Serhiy-K/TFTGLCDAdapter/Hardware/Photos/README.md

# TFTGLCDPanel

**Start screen**

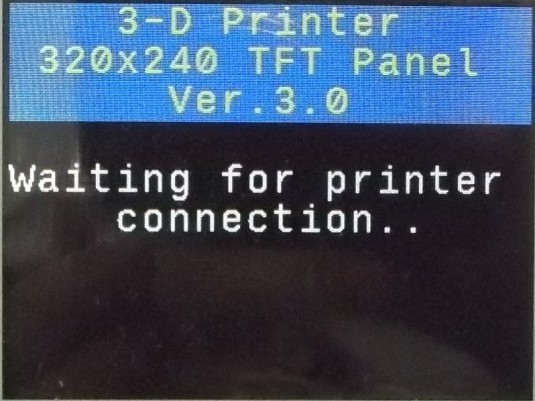
[picture p3: Hardware/Photos/Start-Logo.jpg]


**Marlin-2 logo**

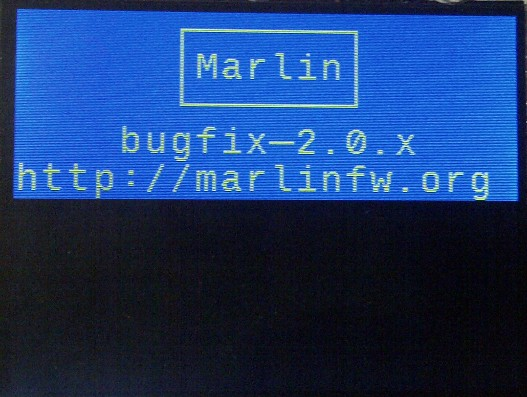
[picture p4: Hardware/Photos/Marlin-2-Logo.jpg]


**Status screen with 1 hotend and bed, Marlin**

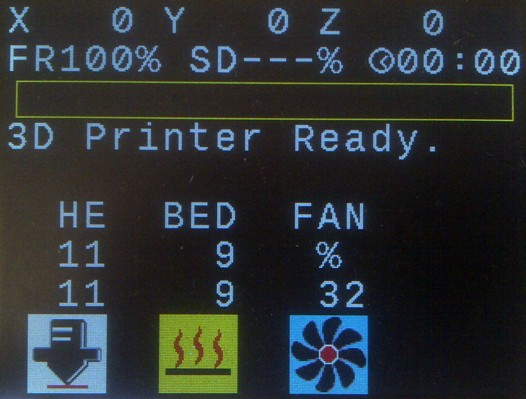
[picture p5: Hardware/Photos/Marlin-1HE.jpg]


**Status screen with 2 hotends, Marlin**

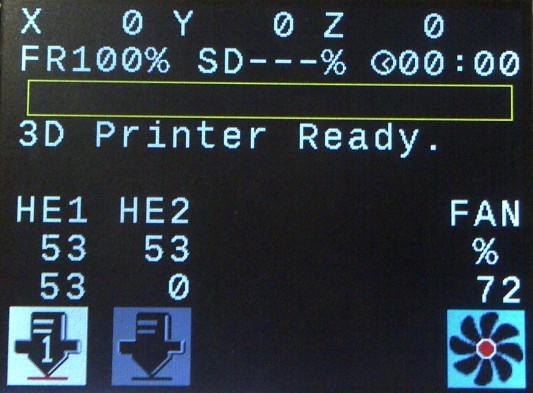
[picture p6: Hardware/Photos/Marlin-2HE.jpg]


**Status screen for lazer, Marlin**

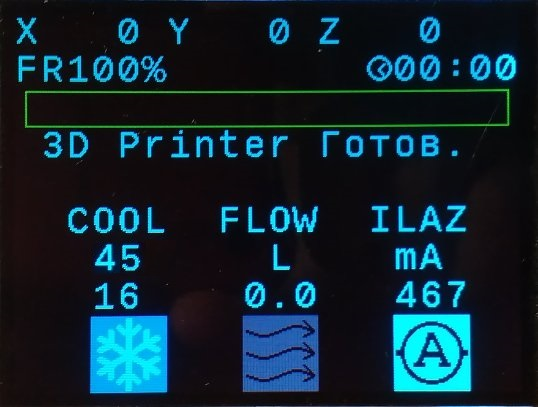
[picture p7: Hardware/Photos/Marlin-Lazer.jpg]


**Status screen with progressbar, Smoothieware**



**Menu, Smoothieware**

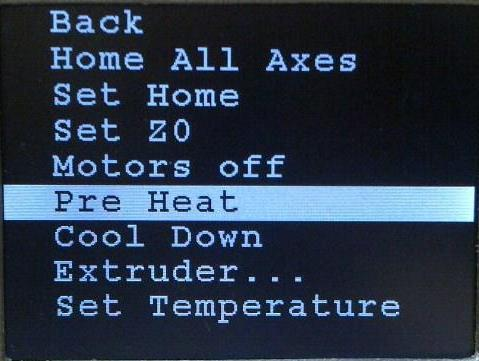
[picture p8: Hardware/Photos/Smoothie-menu.jpg]


**Edit parameter with encoder, Smoothieware**

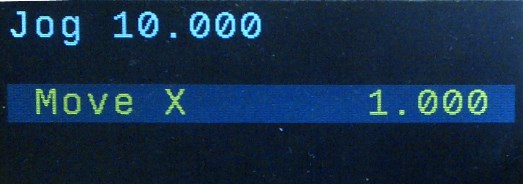
[picture p9: Hardware/Photos/Smoothie-Edit_Param.jpg]


**Edit parameter with touchscreen, Marlin**

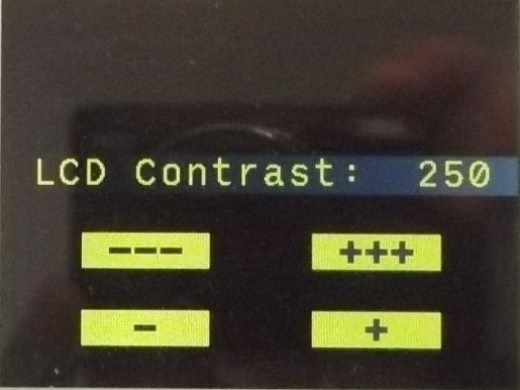
[picture p10: Hardware/Photos/Marlin-Edit_param-V3.jpg]


**UBL: edit mesh with encoder**

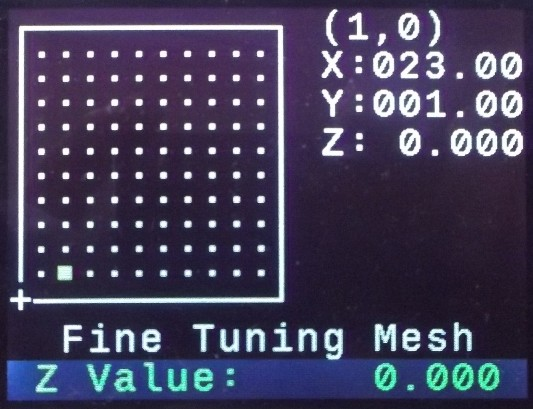
[picture p11: Hardware/Photos/UBL_Mesh_Editor_encoder.jpg]


**UBL: select point with touchscreen**

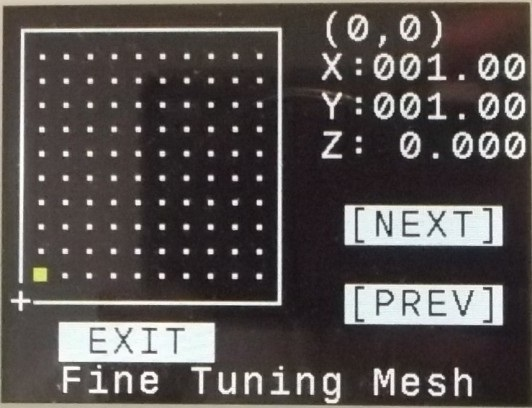
[picture p12: Hardware/Photos/UBL-select-V3.jpg]


**UBL: edit point with touchscreen**

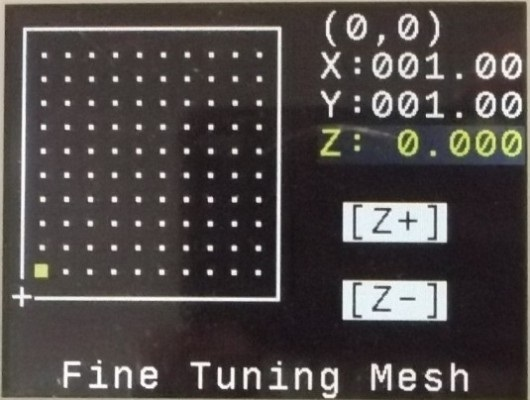
[picture p13: Hardware/Photos/UBL-edt-V3.jpg]


**Error screen, Marlin**

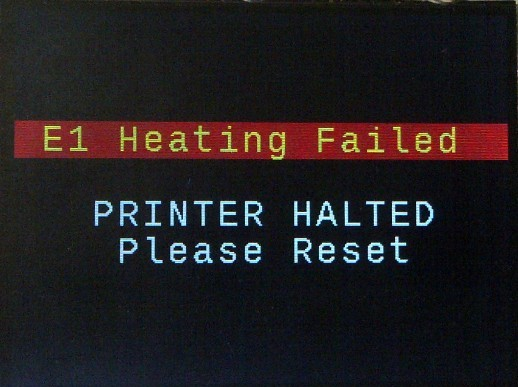
[picture p14: Hardware/Photos/Marlin-Error_Screen.jpg]


**TFTGLCD panel V2 PCB**

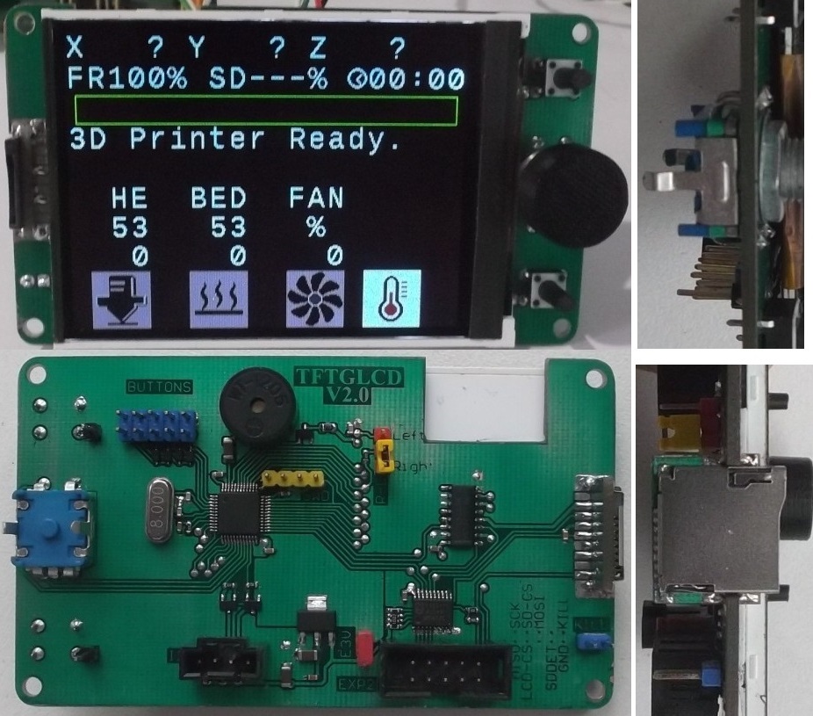
[picture p15: Hardware/Photos/TFTGLCD-V2.jpg]


**TFTGLCD panel V3 in case from chinese "mini Iphone"**

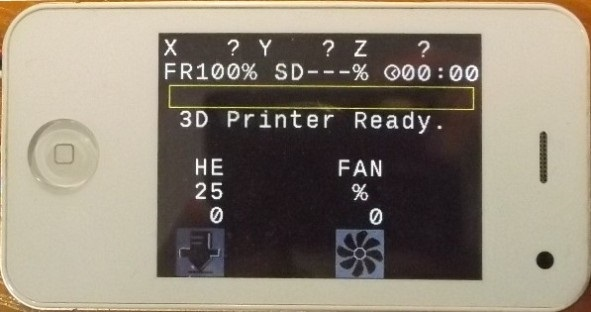
[picture p16: Hardware/Photos/TFTGLCD-V3.jpg]
