Serhiy-K/TFTGLCDAdapter/Firmware/Changelog.txt

01/28/2022

1. Add SD-Botloader support. Need new or changed hardware. See the differences between Version 2.0 and Version 2.1
   hardware for SD-card/SPI bus.
2. Now code support only Version 2.1 hardware for "HW_VER_2". Hardware Version 2.0 will work with this code too.
3. Update README files.

09/13/2021

1. Add "ONLY_MARLIN", "USE_SPI", "USE_I2C" options to reduce ROM size.

07/18/2021

1. Add cutter status for laser/spindle.

07/03/2021

1. Add support for laser in Marlin-2.

05/06/2021

1. Add support for HX8347 LCD chip.

04/01/2021

1. Add rotation for R61509V displays.
2. Remove unneeded code in LCD.c.

03/14/20221

1. Fix touchscreen for Smoothieware.
2. Fix FAN text output in main screen for Smoothieware.

03/06/2021

1. Cnange algorithm for Clear_Screen.

03/01/2021

1. Fix for return from edit contrast in Marlin.

28/02/2021

1. Add support for R61509V LCD chip.
2. Change I2C addres to 0x33 for STM32 main boards.
3. Fix I2C bus interrupt for touchscreen.
4. Fix "Bed" icon.

1. Optimize UBL output.
2. Add comment to touchscreen calibration screen.

12/10/2020

1. Add save/load Y-calibration.
2. Change one sybbol in font for touchscreen test.
3. Move touchscreen functions to separate file.

12/09/2020

1. Add touchscreen rotation according to LCD.

12/06/2020

1. Touchscreen support works fine.
2. Change some pins for LCD for HW_VER_3.

11/08/2020

1. Change output algorithm - remove screen autorefresh.
2. Ad new hardware version for touchscreen for future. Not tested in hardware yet.
3. Add separate timer for buttons and touchscreen.

10/09/2020

1. Change for buttons.

10/04/2020

1. Small code clean up.
2. Change output for icons for extrude1..extrude3 for multiextruder config to icon for single extrude to free ROM.
   Icons for extrude1..extrude3 not deleted from sources and may be used.
3. Small change for progress bar output.

10/03/2020

1. Fix Buzzer for Marlin.
2. Update for Marlin's edit line.
3. Formating defines.h

09/30/2020

1. Add CLR_SCREEN command for Marlin to protocol - optimize bus transfer.
2. Update Readme.

09/25/2020

1. Fix progress bar for Marlin.
2. Change progress bar colors.

09/10/2020

1. Small fix for UBL screen for Marlin.

09/06/2020

1. Fix buttons for Marlin.

09/05/2020

1. Improvement for detect UBL screen.

08/31/2020

1. Remove "symbol" for FAN percent data in line 4 for Smoothieware.
2. Small changes in Courier font.

08/29/2020

1. Add centring for status line on main screen.

08/23/2020

1. Small changes in LiberationMono font.

08/17/2020

1. Fix protocol for Marlin.
2. Fix UBL screen for Marlin.

29/06/2020

1. Add ST7789 LCD chip support.
2. Add dots to grid for Marlin UBL.

06/25/2020

1. Fix init for ILI9341 and ILI9327.

06/20/2020

1. Add new hardware version for support real 16 bit LCD data bus.
2. Remove support 16-bit LCD data bus with 8-bit controller data bus.
3. Change algorithm for output screen buffer.
4. Change encoder init to use gpio interrupt insted STM32 hardware encoder interface.
5. Add LCD_ORIENT_PIN - hardware selection for LCD orientation.
6. Fix 3 chars in LiberationMono font.
7. Fix logo output for Marlin.

03/20/2020

1. Add support for LCD with 16-bit data bus.

02/19/2020

1. Optimize output to screen.
2. Change BUZ_MIN_FREQ to BUZ_FREQ_MP for change input buzzer frequency.

02/12/2020

1. Change project structure - add inc directory, move all project *.h files to it, move main.c to src.
2. Fix wrong start "shadow" icons.
3. Add new BUZ_MIN_FREQ parameter for set minimum frequency for buzzer.
4. Add Makefile and STM32F103C8Tx_FLASH.ld for buld without CoIDE.
5. Add VSCode support.

02/10/2020

1. Change encoder init for INVERT_ENCODER_DIR param.

01/20/2020

1. Change Start Screen text.
2. Small code formating.

01/07/2020

1. Remove transcode from HD44780 encoding. Marlin should send text in extended ASCII with corresponded national codepage.
   Panel font must have the same codepage to outout all national symbols and pseudographic symbols.
2. Add support for buzzer frequency change for Marlin.

11/10/2019

1. Fix error with temps number set for Marlin.
2. Return back two new commands for Marlin.
3. Change in contrast setting.
4. Add grey-color icons for OFF states for hotends, bed and fan.
5. Change some color positions in colors definition for icons.

10/28/2019

1. Code optimisation.
2. Add centering text for Smoothieware on 400x240 LCD.
3. Fix small bugs for output on 400x240 LCD.
4. Change positions for first lines and progressbar for Smoothieware.
5. Update and add new fotos.

10/20/2019

1. Change init and text resolution for ILI9327 LCD. Now screen equal to 24x10 text screen
2. Change for icons output.
3. Remove unneeded commands for Marlin.
4. Add colors selection for menu cursor for Marlin and Smoothieware and error message and edit parameter line for Marlin.
5. Add drawing frame for UBL in Marlin.
6. Add minimum duration for buzzer.
7. Add CHAR_WIDTH-depended posisions for icons.
8. Update and add new fotos.

09/29/2019

1. Add INVERT_ENCODER_DIR option for encodres with swaped A and B signals.
2. Add WITHOUT_HEAT_ICO option for printing "FAN %" text insteed heat icon.
3. Fix printing temterature/fan lines and heat icon position.

09/09/2019

1. Fix error with icons clearing for Marlin.
2. Small change in progress bar drawing.
3. Moving some lines up in defines.h.

09/06/2019

1. Add support for LCD based on ILI9341 chip
2. Set more light blue color for FAN icons

09/04/2019

1. Correction for LCD based on ILI9327 chip.

08/30/2019

1. Change data format for icons

08/27/2019

1. Add I2C bus to schematic and PCB for support Marlin.
2. Add Gerber files for PCB.

08/22/2019

1. Add support for Marlin 1.1.x (by using I2C bus).
2. Change default font to LiberationMono-Regular_16x24, Courier_New_Bold_16x24 left for choice. Some symbols was changed for better reading.
3. Change first 11 default ASCII symbols in font for using with Marlin.
4. Add Progress bar for Smoothieware.
5. Add auto detect adapter resolution for Smoothieware.
6. Add auto detect numbers of hotends for proper icons positions.
7. Add basic support for LCD based on ILI9327 chip with 400x240 screen resolution.
