Serhiy-K/TFTGLCDAdapter/Hardware/AltiumProj/Ver-3/TFTGLCD-V3-sch.pdf

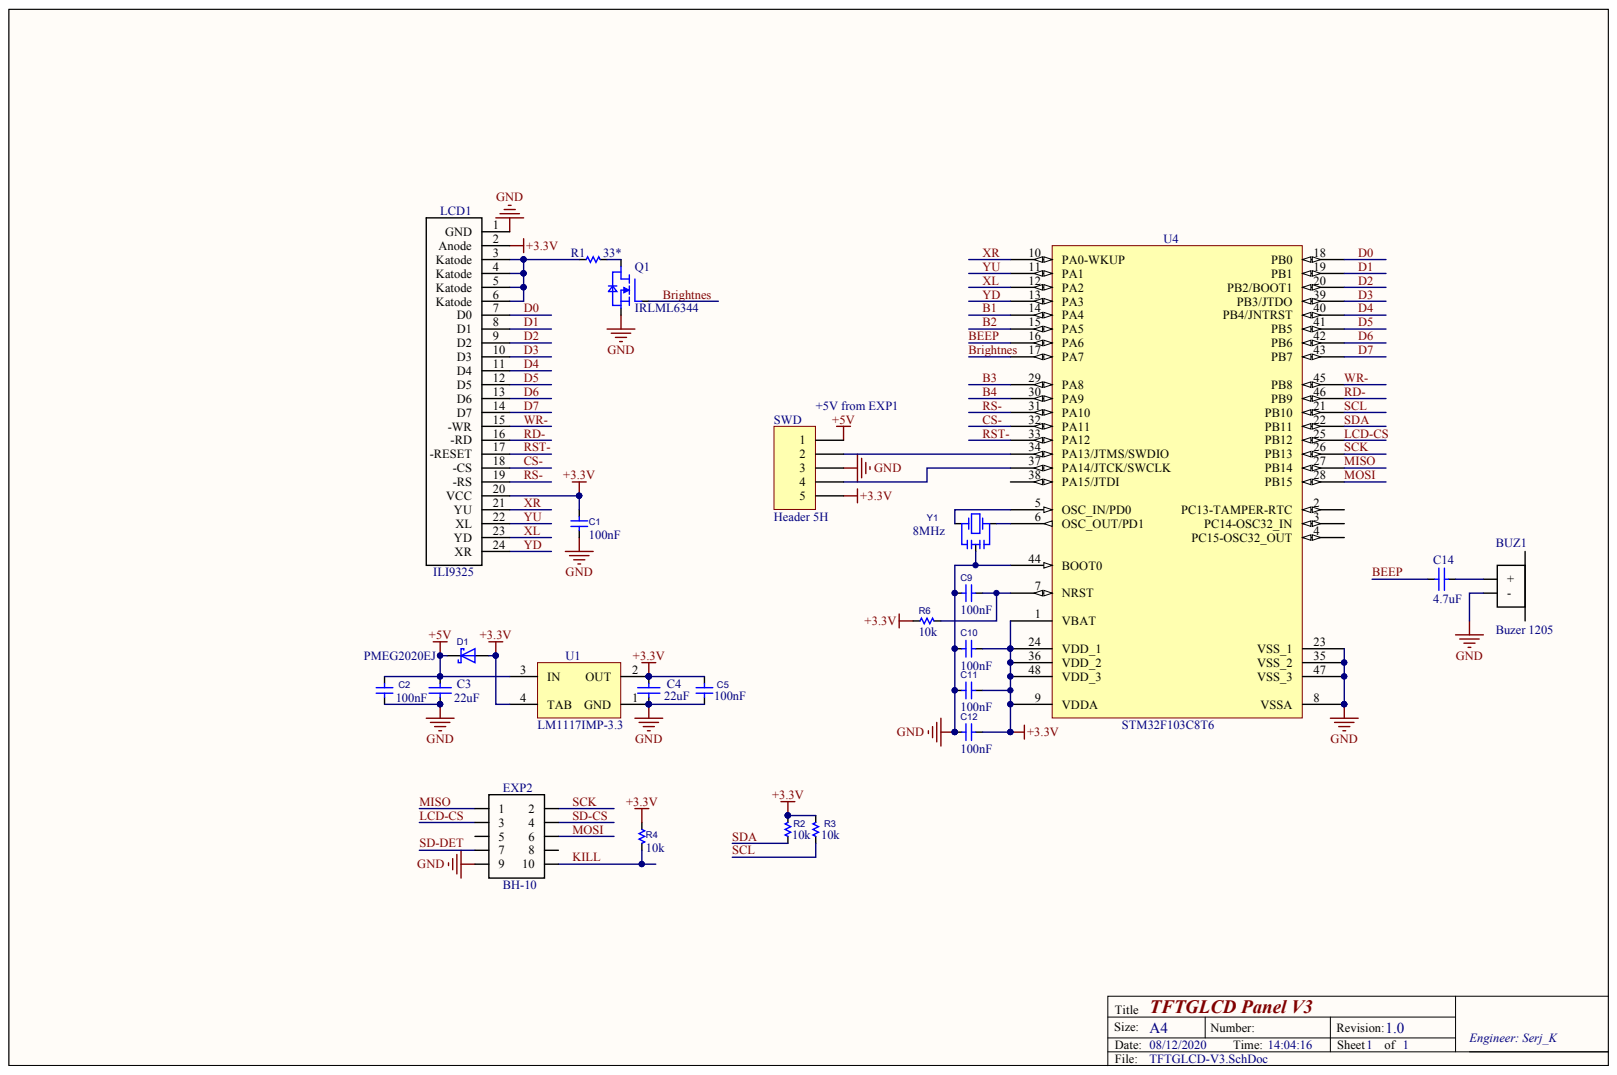
[picture p17: page 1]

PA15/JTDI 38

TFTGLCD Panel V3 Ti t l e | Engineer: Serj_K
Size: A4 | Number: | Revision: 1.0
Date: 08/12/2020 Ti me: 14:04:16 | | Sheet 1 of 1
