Serhiy-K/TFTGLCDAdapter/Hardware/AltiumProj/Ver-2/TFTGLCD-V2.1.pdf

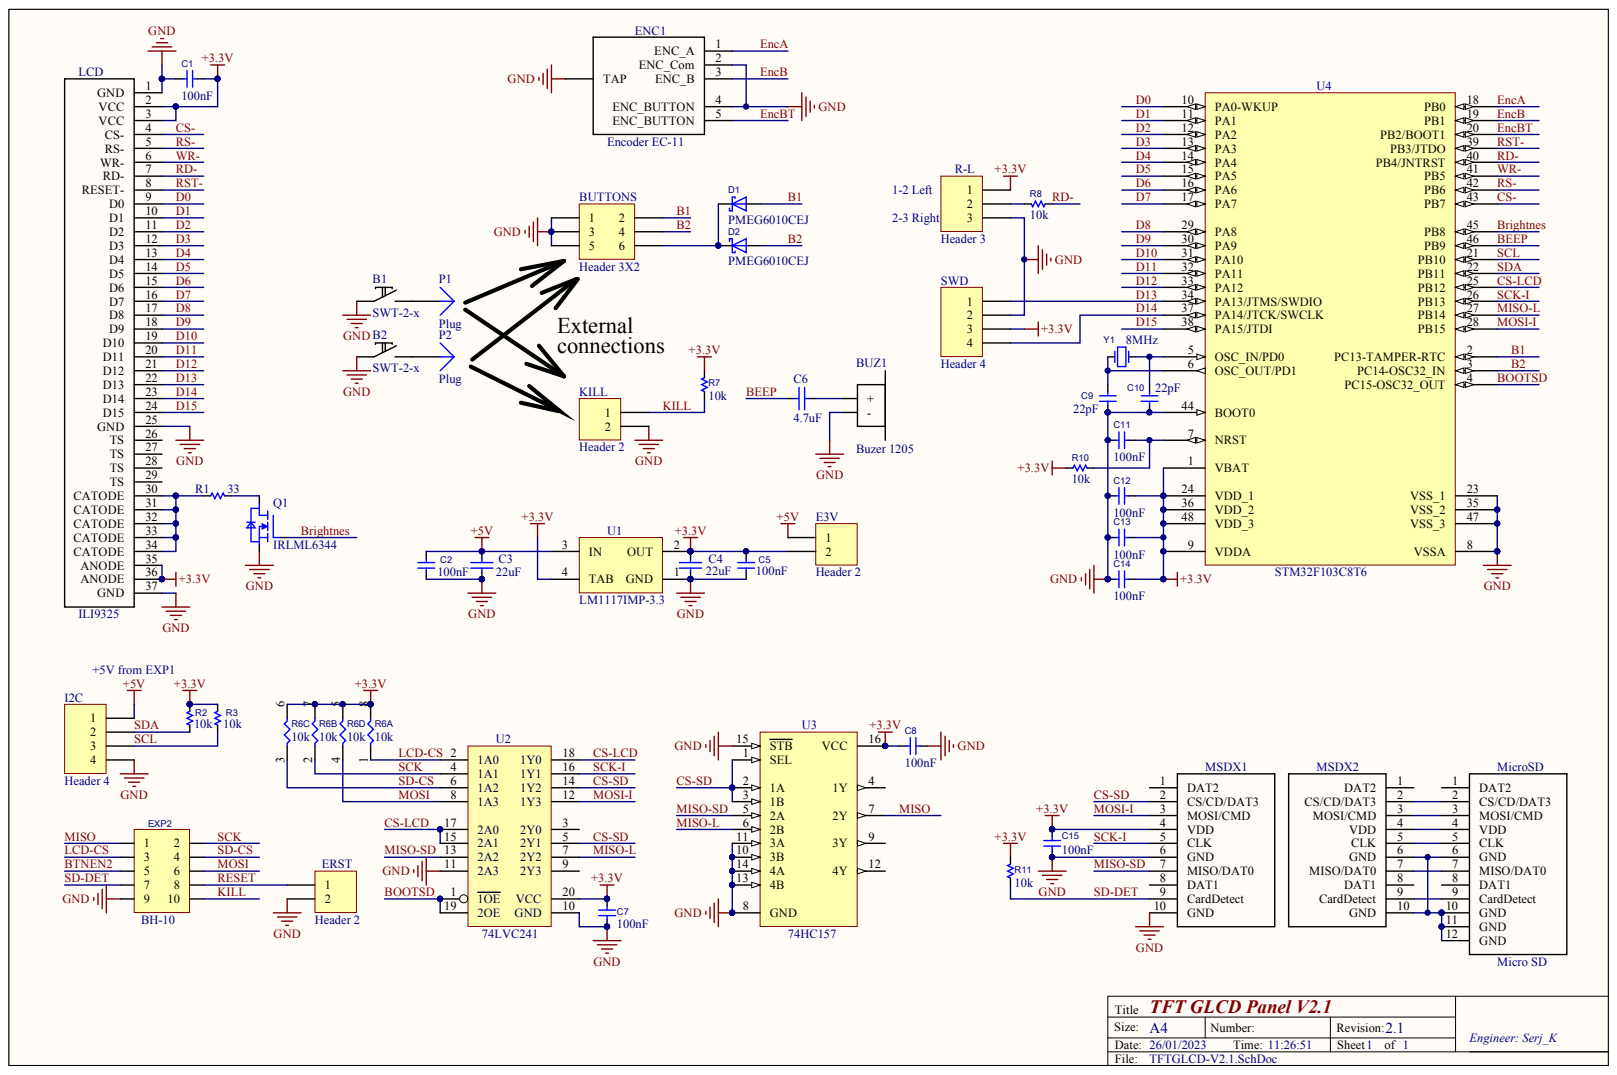
[picture p18: page 1]

D14 | PA14/JTCK/SWCLK 37

PA15/JTDI 38

TFT GLCD Panel V2.1 Title | Engineer: Serj_K
Size: A4 | Number: | Revision: 2.1
Date: 26/01/2023 Time: 11:26:51 | | Sheet 1 of 1
