Serhiy-K/TFTGLCDAdapter/Hardware/AltiumProj/Ver-1/3DP-GLCD-V1-sch.pdf

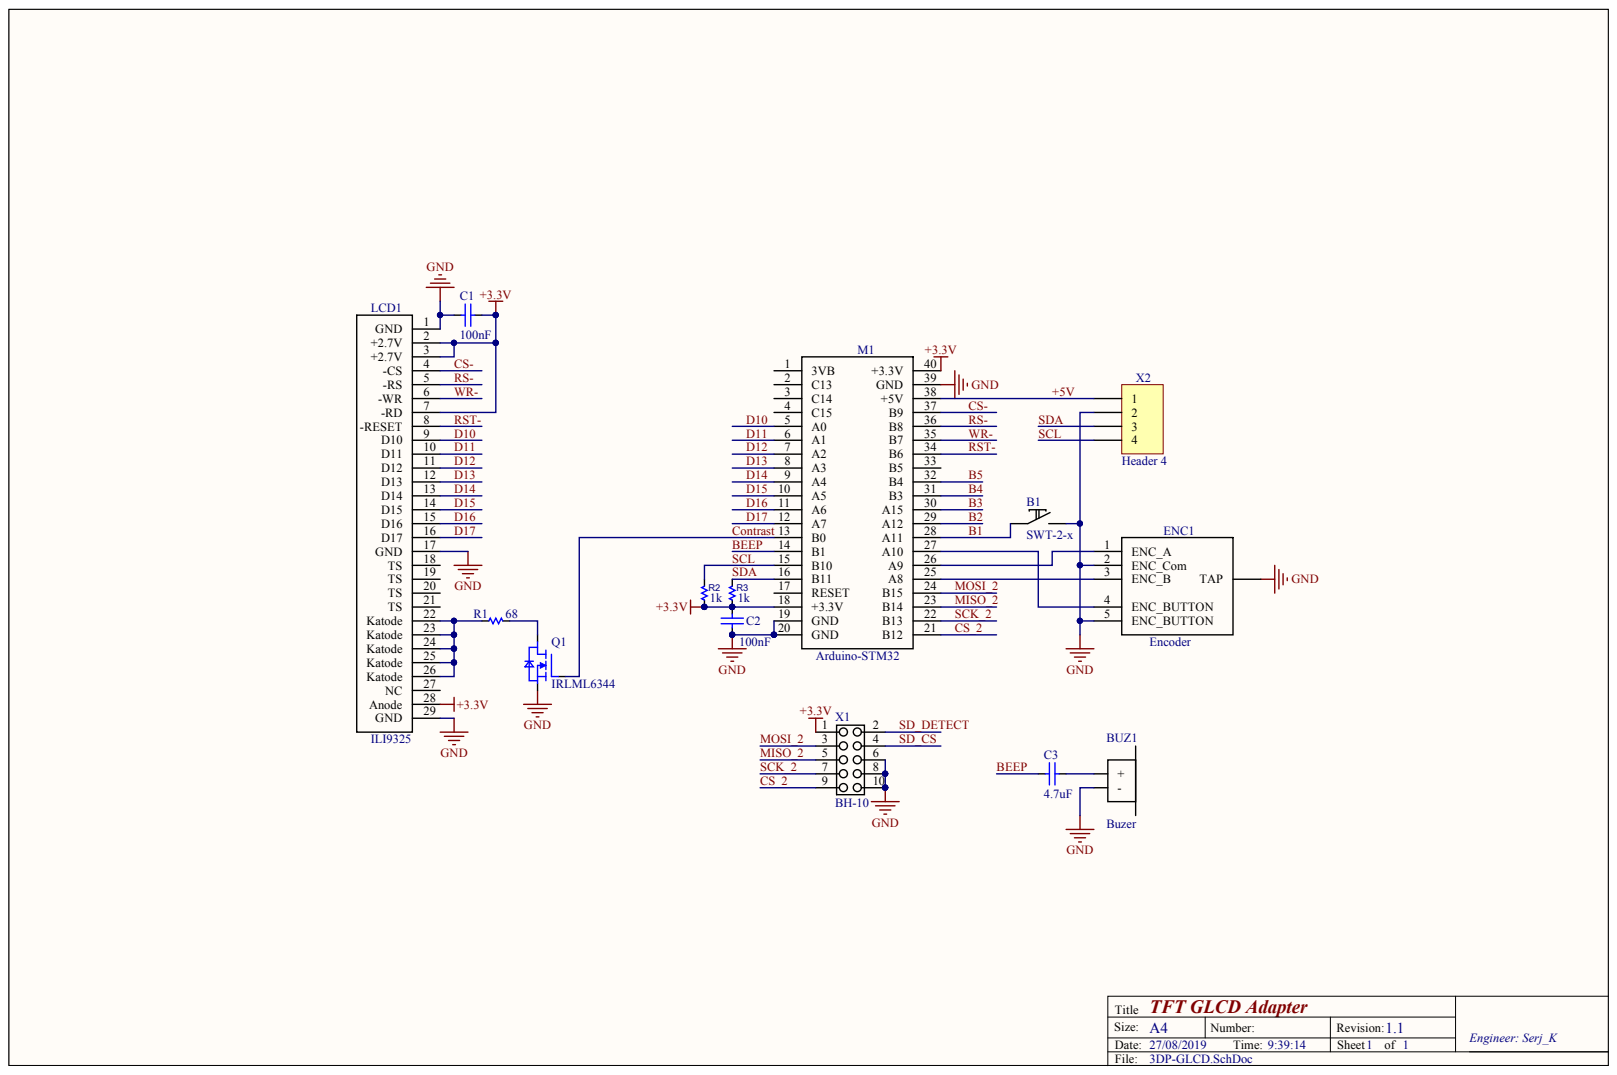
[picture p19: page 1]

TFT GLCD Adapter Title | Engineer: Serj_K
Size: A4 | Number: | Revision: 1.1
Date: 27/08/2019 Time: 9:39:14 | | Sheet 1 of 1
