Serhiy-K/TFTGLCDAdapter/(list of files, drawings)

Other design files:
Hardware/3DP-GLCD.PcbDoc
Hardware/3DP-GLCD.PrjPcb
Hardware/3DP-GLCD.SchDoc
Hardware/AltiumProj/3DP-GLCD.PcbDoc
Hardware/AltiumProj/3DP-GLCD.PrjPcb
Hardware/AltiumProj/3DP-GLCD.SchDoc
