Serhiy-K/TFTGLCDAdapter/Firmware/src/Pictures.c

/*******************************************************************************
* preset name: Color R5G6B5
* data block size: 16 bit(s), uint16_t
* RLE compression enabled: no
* conversion type: Color, not_used not_used
* bits per pixel: 16
*
* preprocess:
*  main scan direction: left_to_right
*  line scan direction: backward
*  inverse: no
*******************************************************************************/
#include "Pictures.h"
#include "LCD.h"

const uint16_t colors[] =
{
	Black, LightBlack, LightBlack2, Gray, LightGray4, LightGray3, LightGray2, LightGray, White,	//A-I
	Red, LightRed, LightRed2,	//J-L
	Green, LightGreen, LightGreen2,	//M-O
	Blue, LightBlue, LightBlue2,	//P-R
	Orange, Orange1, DarkOrange, DarkOrange2,	//S-V
	Yellow, LightSky, StillBlue, Auqa	//W-Z
};

#ifdef USE_3DPRINTER
// single extruler icon
const char extrude_48x48[2304] =
{
     'I','I','I','I','I','I','I','I','I','I','I','I','I','I','I','I','I','I','I','I','I','I','I','I','I','I','I','I','I','I','I','I','I','I','I','I','I','I','I','I','I','I','I','I','I','I','I','I',
     'I','I','I','I','I','I','I','I','I','I','I','I','I','I','I','I','I','I','I','I','I','I','I','I','I','I','I','I','I','I','I','I','I','I','I','I','I','I','I','I','I','I','I','I','I','I','I','I',
     'I','I','I','I','I','I','I','I','I','I','I','I','I','I','I','I','I','I','I','I','I','I','I','I','I','I','I','I','I','I','I','I','I','I','I','I','I','I','I','I','I','I','I','I','I','I','I','I',
     'I','I','I','I','I','I','I','I','I','I','I','I','I','I','I','I','I','I','I','I','H','H','H','H','H','H','H','I','I','I','I','I','I','I','I','I','I','I','I','I','I','I','I','I','I','I','I','I',
     'I','I','I','I','I','I','I','I','I','I','I','I','I','I','I','I','I','I','I','H','A','A','A','A','A','A','A','H','I','I','I','I','I','I','I','I','I','I','I','I','I','I','I','I','I','I','I','I',
     'I','I','I','I','I','I','I','I','I','I','I','I','I','I','I','I','I','I','I','A','A','A','A','A','A','A','A','H','I','I','I','I','I','I','I','I','I','I','I','I','I','I','I','I','I','I','I','I',
     'I','I','I','I','I','I','I','I','I','I','I','I','I','I','I','I','I','I','I','A','A','A','A','A','A','A','A','H','I','I','I','I','I','I','I','I','I','I','I','I','I','I','I','I','I','I','I','I',
     'I','I','I','I','I','I','I','I','I','I','I','I','I','I','I','I','I','I','I','A','A','A','A','A','A','A','A','H','I','I','I','I','I','I','I','I','I','I','I','I','I','I','I','I','I','I','I','I',
     'I','I','I','I','I','I','I','I','I','I','I','I','I','I','I','I','I','I','I','A','A','A','A','A','A','A','A','H','I','I','I','I','I','I','I','I','I','I','I','I','I','I','I','I','I','I','I','I',
     'I','I','I','I','I','I','I','I','I','I','I','I','I','I','I','I','I','I','I','A','A','A','A','A','A','A','A','H','I','I','I','I','I','I','I','I','I','I','I','I','I','I','I','I','I','I','I','I',
     'I','I','I','I','I','I','I','I','I','I','I','I','I','I','I','I','I','I','I','A','A','A','A','A','A','A','A','H','I','I','I','I','I','I','I','I','I','I','I','I','I','I','I','I','I','I','I','I',
     'I','I','I','I','I','I','I','I','I','I','I','I','I','I','I','I','I','I','I','A','A','A','A','A','A','A','A','H','I','I','I','I','I','I','I','I','I','I','I','I','I','I','I','I','I','I','I','I',
     'I','I','I','J','J','I','I','I','I','I','I','I','I','I','I','I','A','A','A','A','A','A','A','A','A','A','A','H','I','I','I','I','I','I','I','I','I','I','I','I','I','I','I','I','I','I','I','I',
     'I','I','I','J','J','I','I','I','I','I','I','I','I','I','I','A','A','A','A','A','A','A','A','A','A','A','A','H','E','E','E','E','E','E','E','E','E','E','E','E','E','E','E','E','I','I','I','I',
     'I','I','I','J','J','I','I','I','I','I','I','I','I','I','A','A','A','A','A','A','A','A','A','A','A','A','A','A','A','A','A','A','A','A','A','A','A','A','A','A','A','A','A','A','E','I','I','I',
     'I','I','I','J','J','I','I','I','I','I','I','I','I','A','A','A','A','A','A','A','A','A','A','A','A','A','A','A','A','A','A','A','I','I','A','A','A','D','I','I','A','A','A','A','A','I','I','I',
     'I','I','I','J','J','I','I','I','I','I','I','I','A','A','A','A','A','A','A','A','A','A','A','A','A','A','A','A','A','A','A','A','I','I','A','A','A','D','I','I','A','A','A','A','A','I','I','I',
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
    'F','F','F','F','F','F','F','F','F','F','F','F','F','F','F','F','F','F','F','F','F','F','F','F','F','F','F','F','F','F','F','F','F','F','F','F','F','F','F','F','F','F','F','F','F','F','F','F'
};
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
