Serhiy-K/TFTGLCDAdapter/Firmware/src/LiberationMono-Regular_16x24.c

/*******************************************************************************
 family: LiberationMono
 style: Regular
 size: 24
 type: monospaced

 encoding: ASCII (cyrillic CP866)
 included characters:  from 0x00 to 0xff

 scan direction: bottom to top, left to right
*******************************************************************************/

#include <stdint.h>


const char LiberationMono_16x24[256][48] = {
{
    0b00000000, 0b00000000, 0b00000000,
    0b00000000, 0b00000000, 0b00000000,
    0b00000000, 0b00000000, 0b00000000,
    0b00000000, 0b00000000, 0b00000000,
    0b00000000, 0b00000000, 0b00000000,
    0b00000000, 0b00000000, 0b00000000,
    0b00000000, 0b00000000, 0b00000000,
    0b00000000, 0b00000000, 0b00000000,
    0b00000000, 0b00000000, 0b00000000,
    0b00000000, 0b00000000, 0b00000000,
    0b00000000, 0b00000000, 0b00000000,
    0b00000000, 0b00000000, 0b00000000,
    0b00000000, 0b00000000, 0b00000000,
    0b00000000, 0b00000000, 0b00000000,
    0b00000000, 0b00000000, 0b00000000,
    0b00000000, 0b00000000, 0b00000000
},
{//0x01 - LCD_DEGREE_CHAR for Marlin
    0b00000000, 0b00000000, 0b00000000,
    0b00000000, 0b00000000, 0b00000000,
    0b00000000, 0b00000000, 0b00000000,
    0b00000000, 0b00000000, 0b11100000,
    0b00000000, 0b00000011, 0b11111000,
    0b00000000, 0b00000011, 0b00011000,
    0b00000000, 0b00000110, 0b00001100,
    0b00000000, 0b00000110, 0b00001100,
    0b00000000, 0b00000110, 0b00001100,
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
    0b00000000, 0b00000000, 0b00000000,
    0b00000000, 0b00000000, 0b00000000
},
{
    0b00000000, 0b00000000, 0b00000000,
    0b00000000, 0b00000000, 0b00000000,
    0b00000000, 0b00000000, 0b00000000,
    0b00000111, 0b11111111, 0b11000000,
    0b00000111, 0b11111111, 0b11000000,
    0b00000000, 0b00011000, 0b00000000,
    0b00000000, 0b00011000, 0b00000000,
    0b00000000, 0b00011000, 0b00000000,
    0b00000000, 0b00011000, 0b00000000,
    0b00000000, 0b00011000, 0b00000000,
    0b00000000, 0b00011000, 0b00000000,
    0b00000111, 0b11111111, 0b11000000,
    0b00000111, 0b11111111, 0b11000000,
    0b00000000, 0b00000000, 0b00000000,
    0b00000000, 0b00000000, 0b00000000,
    0b00000000, 0b00000000, 0b00000000
},
{
    0b00000000, 0b00000000, 0b00000000,
    0b00000000, 0b00000000, 0b00000000,
    0b00000000, 0b00000000, 0b00000000,
    0b00000001, 0b11111111, 0b00000000,
    0b00000011, 0b11111111, 0b10000000,
    0b00000111, 0b00000001, 0b11000000,
    0b00000110, 0b00000000, 0b11000000,
    0b00000110, 0b00000000, 0b11000000,
    0b00000110, 0b00000000, 0b11000000,
    0b00000110, 0b00000000, 0b11000000,
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
