Serhiy-K/TFTGLCDAdapter/Firmware/src/Courier_New_Bold_16x24.c

/*******************************************************************************
 family: Courier New
 style: Bold
 size: 24
 type: monospaced

 encoding: ASCII (cyrillic CP866)
 included characters:  from 0x00 to 0xff

 scan direction: bot to top, left_to_right
*******************************************************************************/

#include <stdint.h>

const char Courier_New_Bold_16x24[256][48] = {
{//0x00
    0b00000000, 0b00000000, 0b00000000,
    0b00000000, 0b00000000, 0b00000000,
    0b00000000, 0b00000000, 0b00000000,
    0b00000000, 0b00000000, 0b00000000,
    0b00000000, 0b00000000, 0b00000000,
    0b00000000, 0b00000000, 0b00000000,
    0b00000000, 0b00000000, 0b00000000,
    0b00000000, 0b00000000, 0b00000000,
    0b00000000, 0b00000000, 0b00000000,
    0b00000000, 0b00000000, 0b00000000,
    0b00000000, 0b00000000, 0b00000000,
    0b00000000, 0b00000000, 0b00000000,
    0b00000000, 0b00000000, 0b00000000,
    0b00000000, 0b00000000, 0b00000000,
    0b00000000, 0b00000000, 0b00000000,
    0b00000000, 0b00000000, 0b00000000
},
{//0x01 - LCD_DEGREE_CHAR for Marlin
    0b00000000, 0b00000000, 0b00000000,
    0b00000000, 0b00000000, 0b00000000,
    0b00000000, 0b00000000, 0b00000000,
    0b00000000, 0b00000000, 0b00000000,
    0b00000000, 0b00000111, 0b10000000,
    0b00000000, 0b00001111, 0b11000000,
    0b00000000, 0b00011100, 0b11100000,
    0b00000000, 0b00011000, 0b01100000,
    0b00000000, 0b00011000, 0b01100000,
    0b00000000, 0b00011100, 0b11100000,
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
    0b00000011, 0b00000001, 0b10000000,
    0b00000011, 0b00000001, 0b10000000,
    0b00000000, 0b00000000, 0b00000000
},
{
    0b00000000, 0b00000000, 0b00000000,
    0b00000011, 0b00000001, 0b10000000,
    0b00000011, 0b00000001, 0b10000000,
    0b00000011, 0b11111111, 0b10000000,
    0b00000011, 0b11111111, 0b10000000,
    0b00000011, 0b00011001, 0b10000000,
    0b00000011, 0b00011001, 0b10000000,
    0b00000000, 0b00011000, 0b00000000,
    0b00000000, 0b00011000, 0b00000000,
    0b00000011, 0b00011001, 0b10000000,
    0b00000011, 0b00011001, 0b10000000,
    0b00000011, 0b11111111, 0b10000000,
    0b00000011, 0b11111111, 0b10000000,
    0b00000011, 0b00000001, 0b10000000,
    0b00000011, 0b00000001, 0b10000000,
    0b00000000, 0b00000000, 0b00000000
},
{
    0b00000000, 0b00000000, 0b00000000,
    0b00000000, 0b00000000, 0b00000000,
    0b00000000, 0b01111100, 0b00000000,
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
