Serhiy-K/TFTGLCDAdapter/(commit log)

2019-06-25 New git repository
    [3DP-GLCD.PcbDoc, 3DP-GLCD.PrjPcb, 3DP-GLCD.SchDoc]
2019-08-15 Update for Marlin support
2019-08-15 Fix error with Marlin
    [protocol.c]
2019-08-22 Add support for Marlin 1.1.9
2019-08-27 Update hardware to add I2C bus for Marlin
    [3DP-GLCD.PcbDoc, 3DP-GLCD.SchDoc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]
2019-09-09 Fix error with icons clearing for Marlin
    [LCD.c, defines.h, protocol.c]
2019-09-30 Add new option
    [3DP-GLCD.PcbDoc, 3DP-GLCD.PrjPcb, 3DP-GLCD.SchDoc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]
2019-10-01 Fix FAN percent output for Smoothieware
    [protocol.c]
2019-10-03 Fix bug with 400x240 LCD
    [protocol.c]
2019-10-21 Changes for Marlin
2019-10-28 Opimisation and fix bugs
    [LCD.c, protocol.c]
2020-01-08 Input in extended ASCII encoding, buzzer
    [Courier_New_Bold_16x24.c, LCD.c, LiberationMono-Regular_16x24.c, defines.h, init.c, main.c, protocol.c]
2020-01-10 Repository reorganization, add files for Marlin
2020-02-10 Remove hardware separate files and add archives
    [3DP-GLCD.PcbDoc, 3DP-GLCD.PrjPcb, 3DP-GLCD.SchDoc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]
2020-02-12 Change project stucture, fix bug with start "shadow" icons, add Makefile
    [LCD.h, Pictures.h, defines.h, main.c, protocol.c, protocol.h]
2020-02-13 Add buzzer frequency multiplier
    [defines.h, protocol.c]
2020-06-25 Fix init for ILI9341 and ILI9327
    [LCD.c]
2020-06-29 Add dots to grid for Marlin UBL
2020-08-09 Fix UBL screen and version on logo
    [LCD.c, protocol.c]
2020-08-10 Fix I2C bus wires names on input connector
2020-08-12 Fix I2C IRQ
2020-08-17 Fix protocol and UBL
    [main.c, protocol.c, protocol.h]
2020-08-20 Update PCB project for V2 and Readme.md
2020-08-23 Change I2C_Addr
2020-08-31 Fix FAN percent for Smoothieware
    [Courier_New_Bold_16x24.c, protocol.c]
2020-09-06 Fix buttons for Marlin
    [protocol.c]
2020-09-10 Fix for UBL screen
    [protocol.c]
2020-10-03 Updates for new Marlin
2020-10-04 Code clean up and fix for progress bar
    [protocol.c]
2020-10-09 Change for buttons
2020-12-03 Add test touch and fixex
    [LCD.c, LCD.h, defines.h, init.c, protocol.c]
2020-12-10 Add save Y-calibration constants
2020-12-10 Fix for touchscreen calibration
    [touchscreen.c]
2020-12-10 Add debug info for Y-calibration
2021-01-10 Fix for UBL and touchscreen
    [protocol.c, touchscreen.c]
2021-02-28 Fix for tochscreen and add new LCD chip
    [LCD.c, defines.h, protocol.c, touchscreen.c]
2021-02-28 Fix Bed icon
2021-03-01 Test fix for return from edit contrast in Marlin
    [protocol.c]
2021-03-08 Fix letter "c" in font
    [LiberationMono-Regular_16x24.c]
2021-03-14 Fix touchscreen and FAN text for Smoothieware.
    [protocol.c, touchscreen.c]
2021-05-04 Fix for HX8347 test
    [LCD.c]
2021-07-03 Add support for laser in Marlin-2
2021-07-18 Add cutter status for laser/spindle
2021-07-18 Fix icon positions for laser
    [protocol.c]
2021-09-27 Small optimisations and fix for MCU with 128k
    [defines.h, protocol.c, settings.c]
2023-01-27 Add "Reset" button to V2.1 board
